bigandstone/TiCup_21th_DistortionCalculator/SCH_CT117E_M4_V1.2.pdf

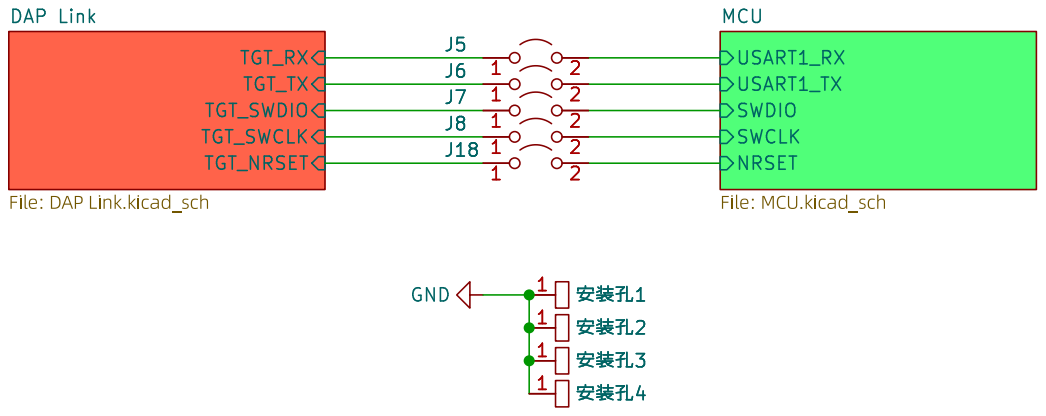
[picture p10: page 1]

TGT_SWCLK DAP Link File: DAPLink.kicad_sch

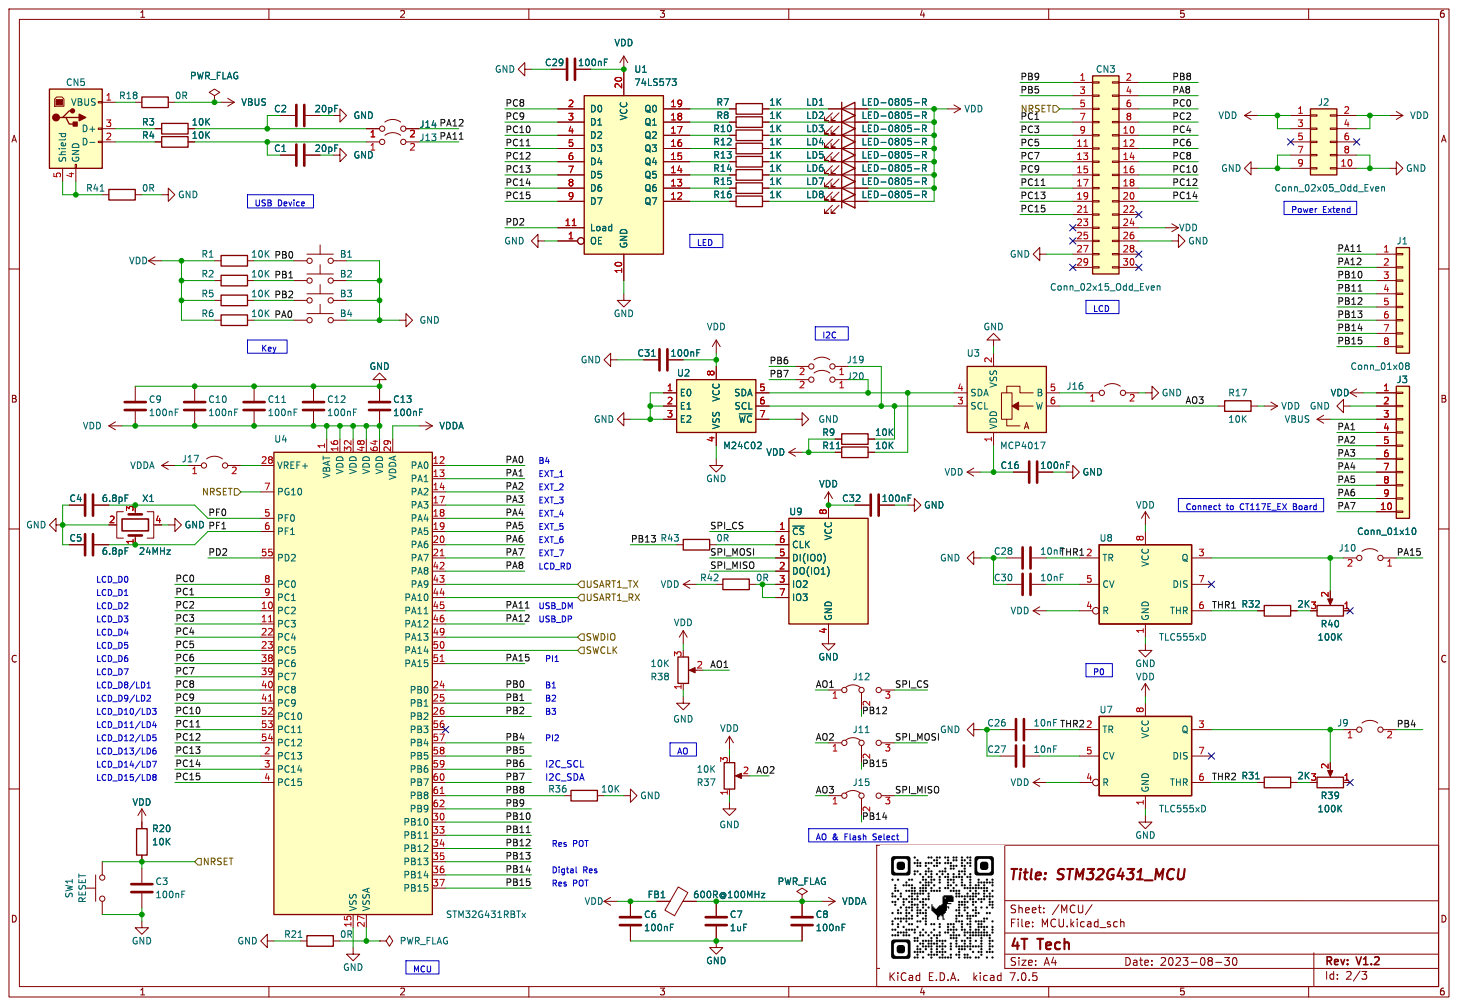
[picture p11: page 2]

4 SDA 5 SCL 6 ~{WC}7 VCC

1 PC2 10 PC3 11 PA0 12 PA1 13 PA2 14 VSS 15 VDD 16 PA3 17 PA4 18 PA5 19 PC13 2 PA6 20 PA7 21 PC4 22 PC5 23 PB0 24 PB1 25 PB2 26 VSSA 27 VREF+ 28 VDDA 29 PC14 3 PB10 30 VDD 32 PB11 33 PB12 34 PB13 35 PB14 36 PB15 37 PC6 38 PC7 39 PC15 4 PC8 40 PC9 41 PA8 42 PA9 43 PA10 44 PA11 45 PA12 46 VDD 48 PA13 49 PF0 5 PA14 50 PA15 51 PC10 52 PC11 53 PC12 54 PD2 55 PB3 56 PB4 57 PB5 58 PB6 59 PF1 6 PB7 60 PB8 61 PB9 62 VDD 64 PG10 7 PC0 8 PC1 9 U4 STM32G431RBTx

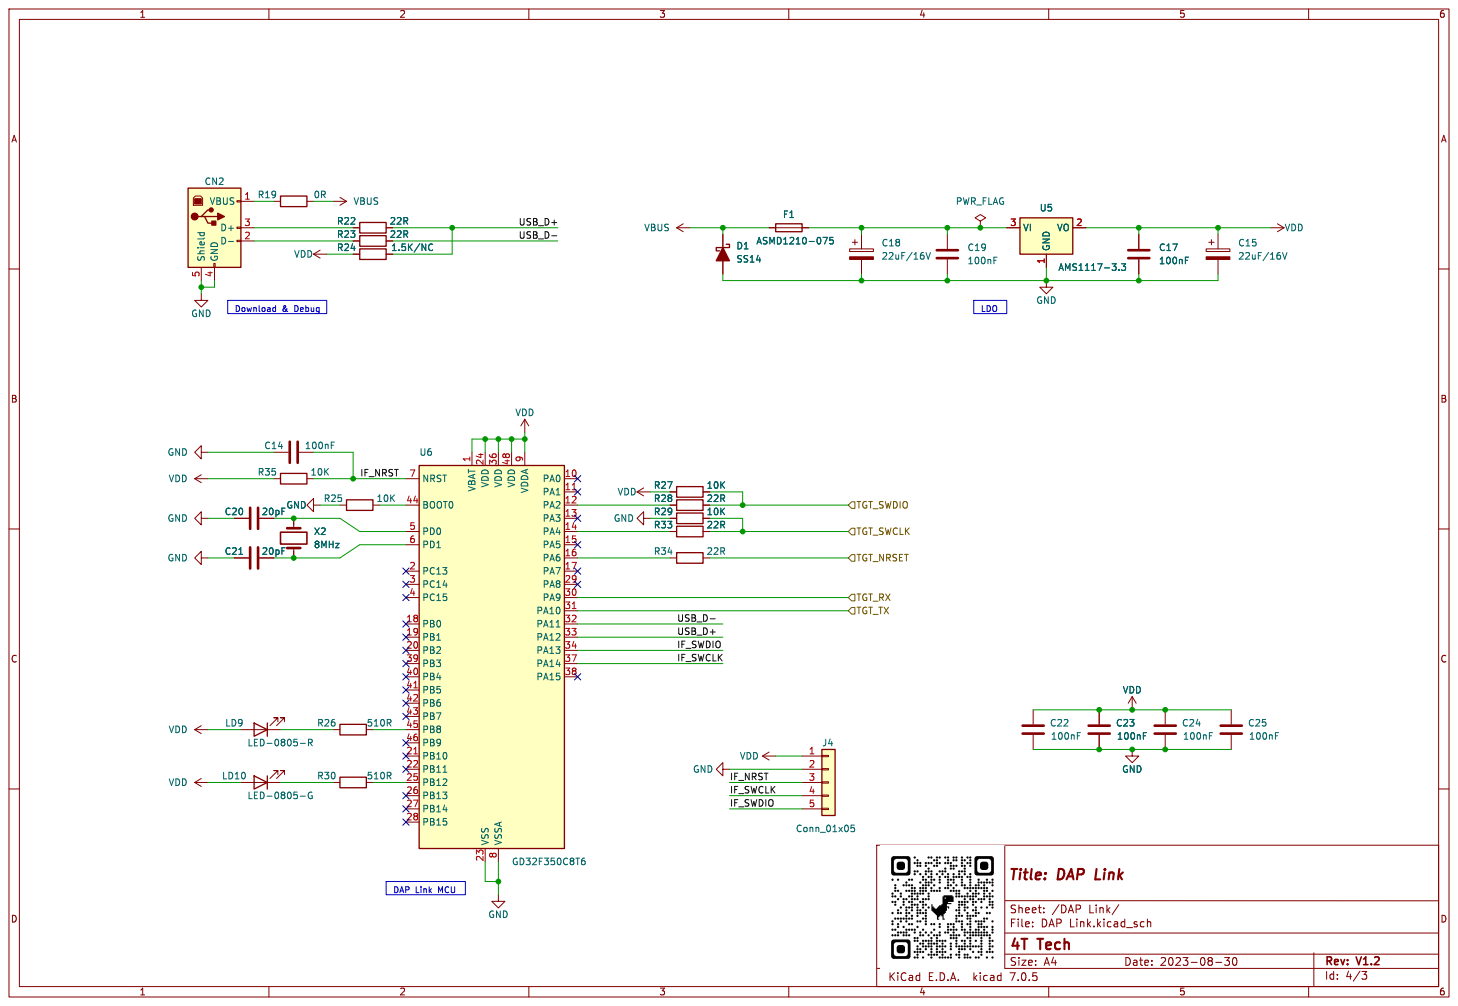
[picture p12: page 3]

1 PA0 10 PA1 11 PA2 12 PA3 13 PA4 14 PA5 15 PA6 16 PA7 17 PB0 18 PB1 19 PC13 2 PB2 20 PB10 21 PB11 22 VSS 23 VDD 24 PB12 25 PB13 26 PB14 27 PB15 28 PA8 29 PC14 3 PA9 30 PA10 31 PA11 32 PA12 33 PA13 34 VDD 36 PA14 37 PA15 38 PB3 39 PC15 4 PB4 40 PB5 41 PB6 42 PB7 43 BOOT0 44 PB8 45 PB9 46 VDD 48 PD0 5 PD1 6 NRST 7 VSSA

Id: 4/3 Title: DAP Link
