bigandstone/TiCup_21th_DistortionCalculator/(list of files, drawings)

Other design files:
ProPrj_信号失真度测量_2025-12-22.epro
