bigandstone/TiCup_21th_DistortionCalculator/DistortionCalculator/DistortionCalculator.ioc

Mcu.UserName=STM32G431RBTx
PA10.Signal=USART1_RX
PA13.Signal=SYS_JTMS-SWDIO
PA14.Signal=SYS_JTCK-SWCLK
PA9.Signal=USART1_TX
PB0.Signal=GPIO_Input
PB1.Signal=GPIO_Input
PB12.GPIO_Label=ADC_INPUT
PB12.Signal=ADC1_IN11
PC10.Signal=GPIO_Output
PC11.Signal=GPIO_Output
PC12.Signal=GPIO_Output
PC13.Signal=GPIO_Output
PC14-OSC32_IN.Signal=GPIO_Output
PC15-OSC32_OUT.Signal=GPIO_Output
PC8.Signal=GPIO_Output
PC9.Signal=GPIO_Output
PD2.GPIO_Label=LED_EN
PD2.Signal=GPIO_Output
PF0-OSC_IN.Signal=RCC_OSC_IN
PF1-OSC_OUT.Signal=RCC_OSC_OUT
