bigandstone/TiCup_21th_DistortionCalculator/DistortionCalculator/Core/Inc/main.h

#define ADC_INPUT_Pin GPIO_PIN_12
#define ADC_INPUT_GPIO_Port GPIOB
#define LED_EN_Pin GPIO_PIN_2
#define LED_EN_GPIO_Port GPIOD
