bigandstone/TiCup_21th_DistortionCalculator/(notices)

Notices in the files:
DistortionCalculator/Core/Inc/main.h:
Copyright (c) 2025 STMicroelectronics.
All rights reserved.
This software is licensed under terms that can be found in the LICENSE file
